Jeroen6/visionplayer/README.md

visionplayer
============

VisionPlayer is a Embedded Vision Project build for the Embedded Vision Minor HAN (http://www.han.nl/)

The device plays audio from a drawn sketch folded around a cilinder

Image: https://raw2.github.com/Zwartepiet/visionplayer/master/docs/HTML%20docs/Productrapport/images/image24.png

A complementary stepper motor control is used to rotate the cilinder at a speed read from 7 segments symbols on the sketch.

https://github.com/Jeroen6/Stepper-Motor-Board
