Jeroen6/visionplayer/docs/Poster.pdf

# Embedded Vision Player

# Realtime muziek

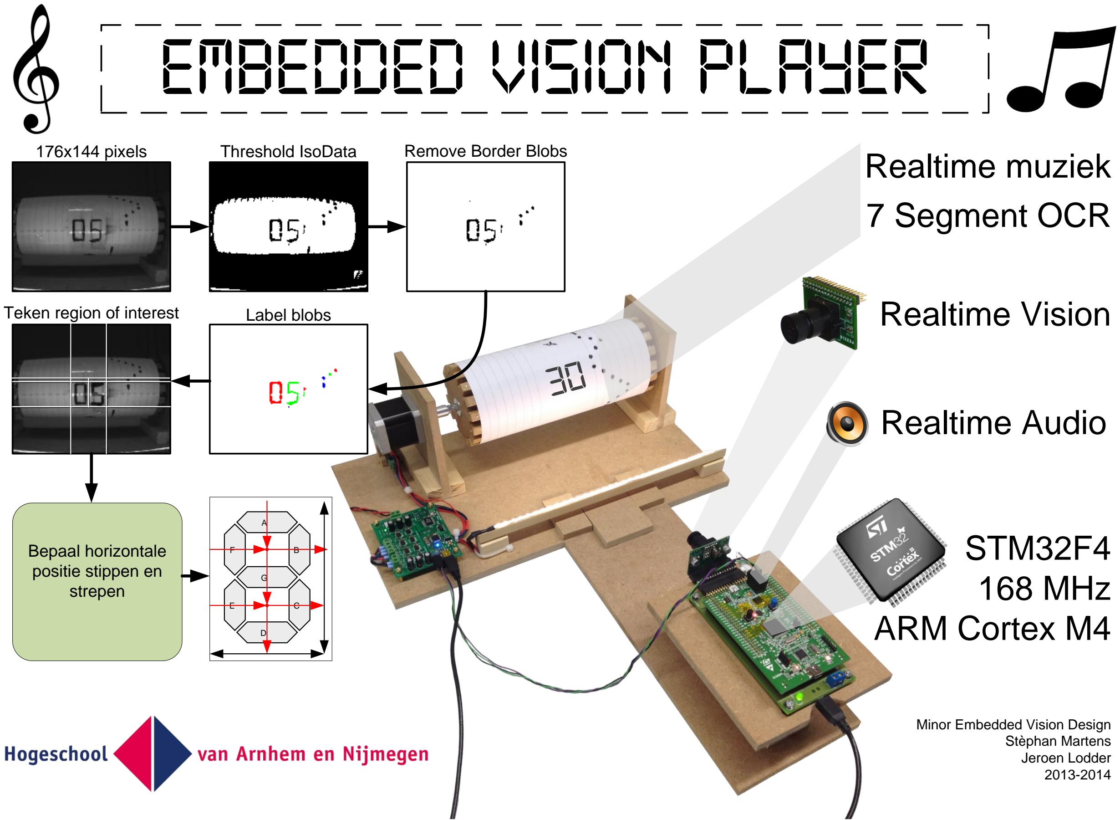
[picture p26: page 1]

# Realtime Vision

# STM32F4 168 MHz ARM Cortex M4

# Realtime Audio

30

# 7 Segment OCR

A | B

C D E

F | G

Bepaal horizontale
positie stippen en
strepen
176x144 pixels | Threshold IsoData | Remove Border Blobs
Teken region of interest | Label blobs

Minor Embedded Vision Design Stèphan Martens
Jeroen Lodder
2013-2014
