Jeroen6/visionplayer/docs/HTML docs/HandleidingVisionPlayer/images/image01.png

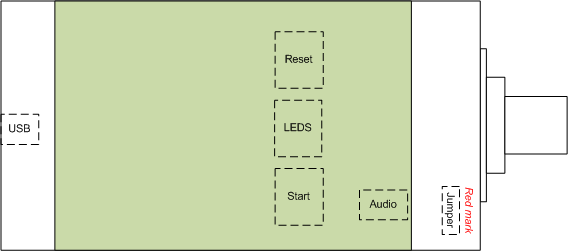
docs/HTML docs/HandleidingVisionPlayer/images/image01.png
