Jeroen6/visionplayer/docs/HTML docs/HandleidingVisionPlayer/images/image03.png

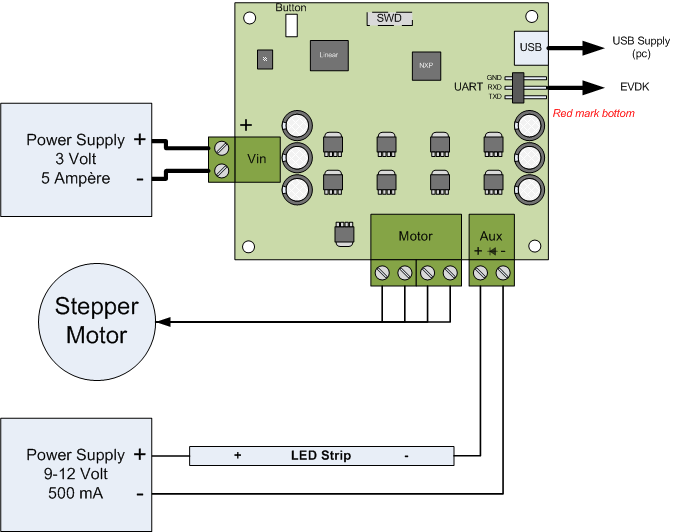
docs/HTML docs/HandleidingVisionPlayer/images/image03.png
