Jeroen6/visionplayer/docs/STM32 F4 Discovery.jpg

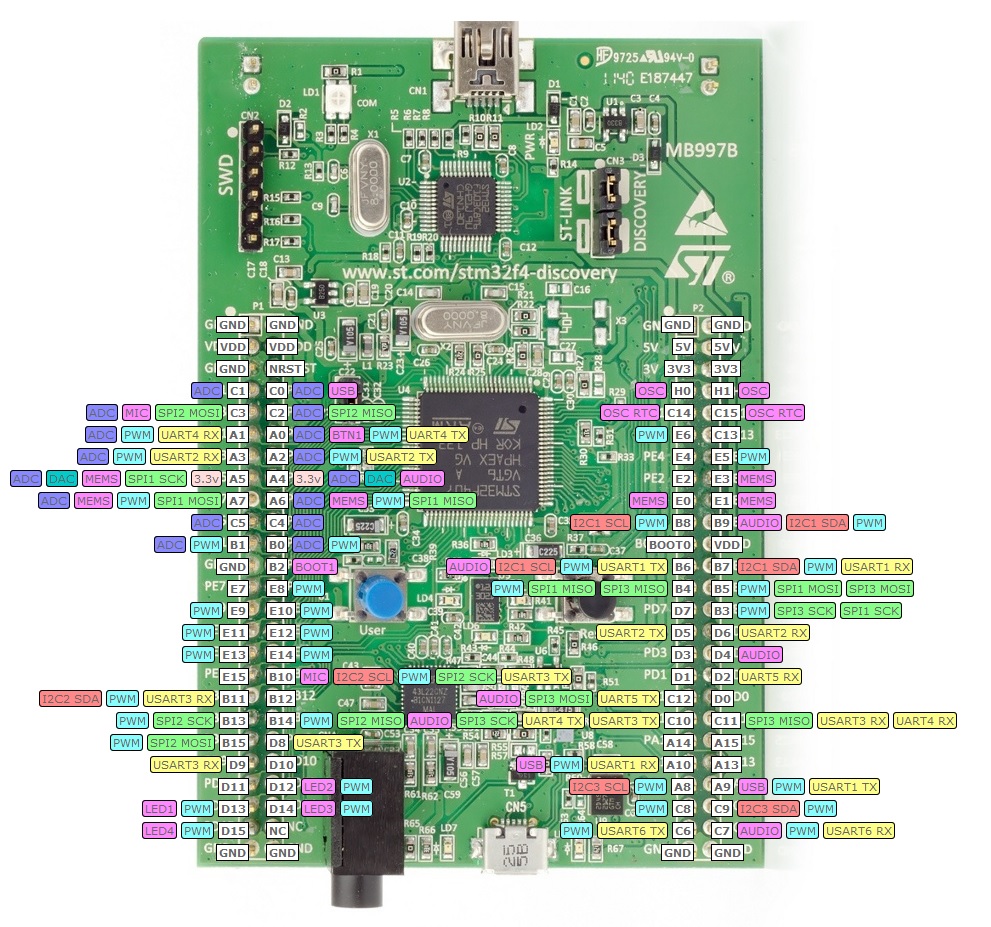
docs/STM32 F4 Discovery.jpg
