Jeroen6/visionplayer/project/inc/VisionSet.h

/******************************************************************************
 * Project    : Embedded Vision Design
 * Copyright  : 2012 HAN Embedded Systems Engineering
 * Author     : Hugo
 *
 * Description: Header file for all the vision sets
 *
 ******************************************************************************
  Change History:

    Version 1.0 - September 2011
    > Initial revision

******************************************************************************/
#ifndef _VISIONSET_H_
#define _VISIONSET_H_

#include "operators.h"
#include "pc_interface.h"

// ----------------------------------------------------------------------------
// Function prototypes
// ----------------------------------------------------------------------------
void VisionSet1 (image_t *pSrc, image_t *pDst);
#endif // _VISIONSET_H_
