Jeroen6/visionplayer/project/inc/operators.h

#include "../operators/operators.h"

// ----------------------------------------------------------------------------
// EOF
// ----------------------------------------------------------------------------
