Jeroen6/visionplayer/project/src/operators.c

#include "../operators/operators.cpp"

// ----------------------------------------------------------------------------
// EOF
// ----------------------------------------------------------------------------
