Jeroen6/visionplayer/project/inc/camera_io.h

/******************************************************************************
 * Project    : Embedded Vision Design
 * Copyright  : 2012 HAN Embedded Systems Engineering
 * Author     : Oscar
 *
 * Description: Header file for camera I/O
 *
 ******************************************************************************
  Change History:

    Version 1.0 - December 2011
    > Initial revision

******************************************************************************/
#ifndef CAMERA_IO_H_
#define CAMERA_IO_H_

// ----------------------------------------------------------------------------
// Function prototypes
// ----------------------------------------------------------------------------
void camera_io_init(void);
void camera_io_reset(void);

#endif /* CAMERA_IO_H_ */
