Jeroen6/visionplayer/(commit log)

2014-01-14 Added motor control via UART3
    removed some files that are gone anyway on Clean Target
2014-01-21 Small bug fix for tone detection
    [VisionSet_project.c, musicplayer.c, musicplayer.h]
2014-01-21 Working Alpha,
    - Implemented 7 segment
    - Implemented user button
    - Several environment optimisations (xRAMn regions etc)
    - Several optimiser settings to O3 + time
    - Tested motor control
2014-01-22 Improve tone detection & replace tabs by spaces.
    [VisionSet_project.c, motor.c, musicplayer.c, musicplayer.h]
2014-01-23 Create README.md
    Embedded Vision Player is a device that plays music from a cilindrical drawing paper.
    Like a music box, but visual.
